Xinyuan-LilyGO/T-CameraPlus-S3/relevant_test/PowerConsumptionTestLog_[T-CameraPlus-S3_V1.2]_20250408.pdf

# T-CameraPlus-S3_V1.2 Power Consumption Test Log

## 1. Test Environment Description

Test Tools | Sampling speed | Test Methodology | Input voltage | Test environment temperature
BLU939 | 100000 times/s | Battery Interface Measurement | +4.0V | 25°C/77°F

www.lilygo.cc

Date: 20250408
LastEditTime: 20250408
Test board: T-CameraPlus-S3_V1.2（202503071622） Software name: Deep_Sleep_Wake_Up.ino
Testing organization: LILYGO Laboratory

## 2. Test Physical Object Image

Test device | MCU | Power amplifier | Microphone | Camera
Corresponding
model | ESP32S3 | MAX98357AETE+T | MP34DT05TR-A | OV2640

1.1 测试环境
1.1 Test environment

1.2 测试的器件型号
1.2 Test device model

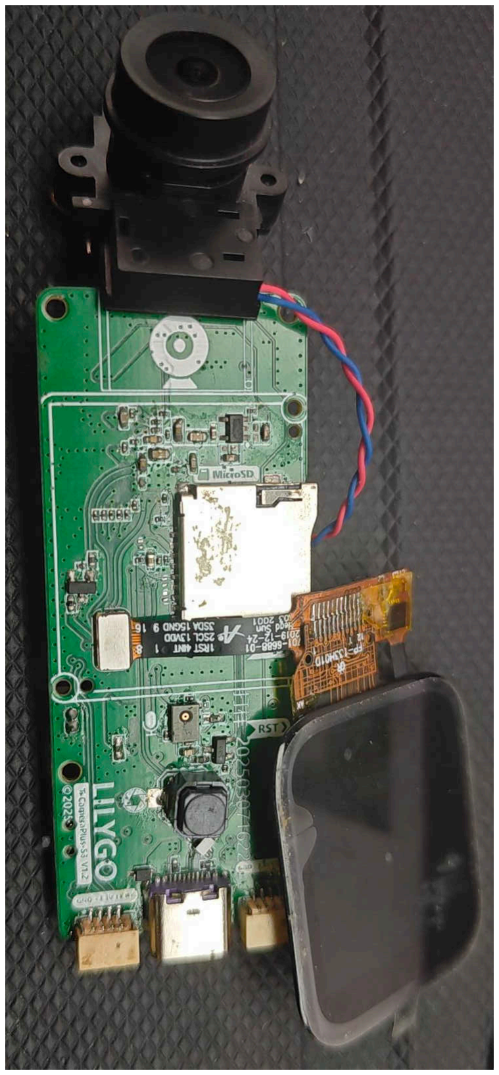
[picture p8: figure]
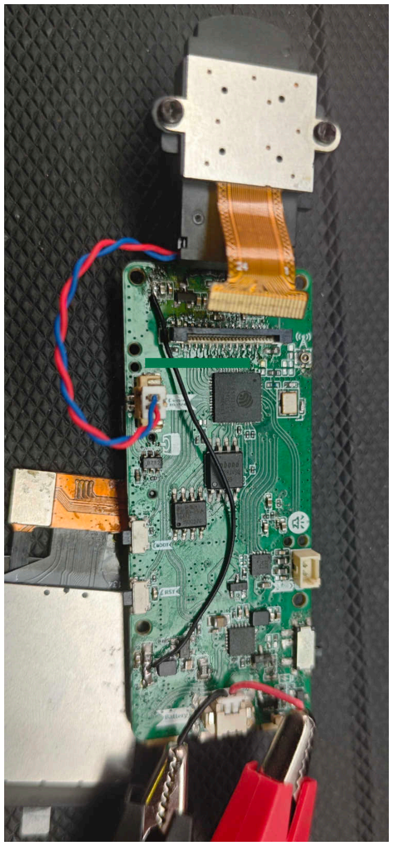
[picture p9: figure]
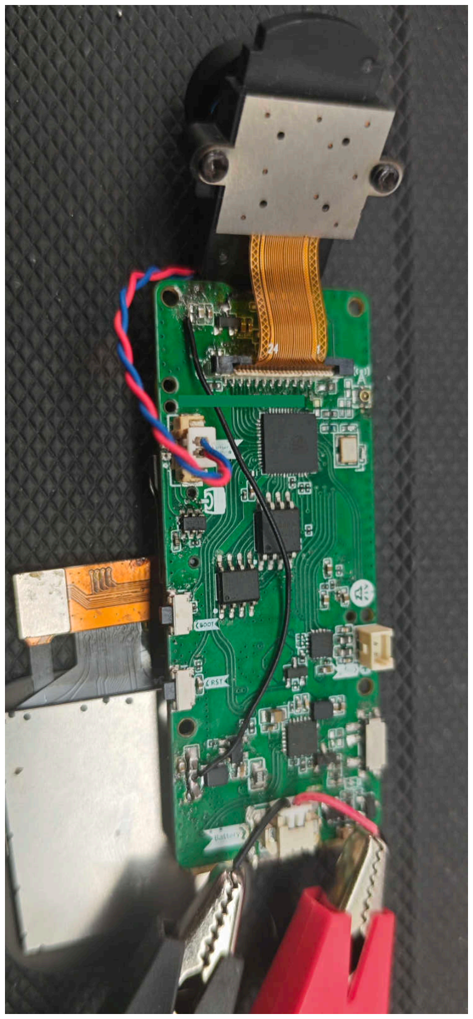
[picture p10: figure]

## 4. Power consumption testing

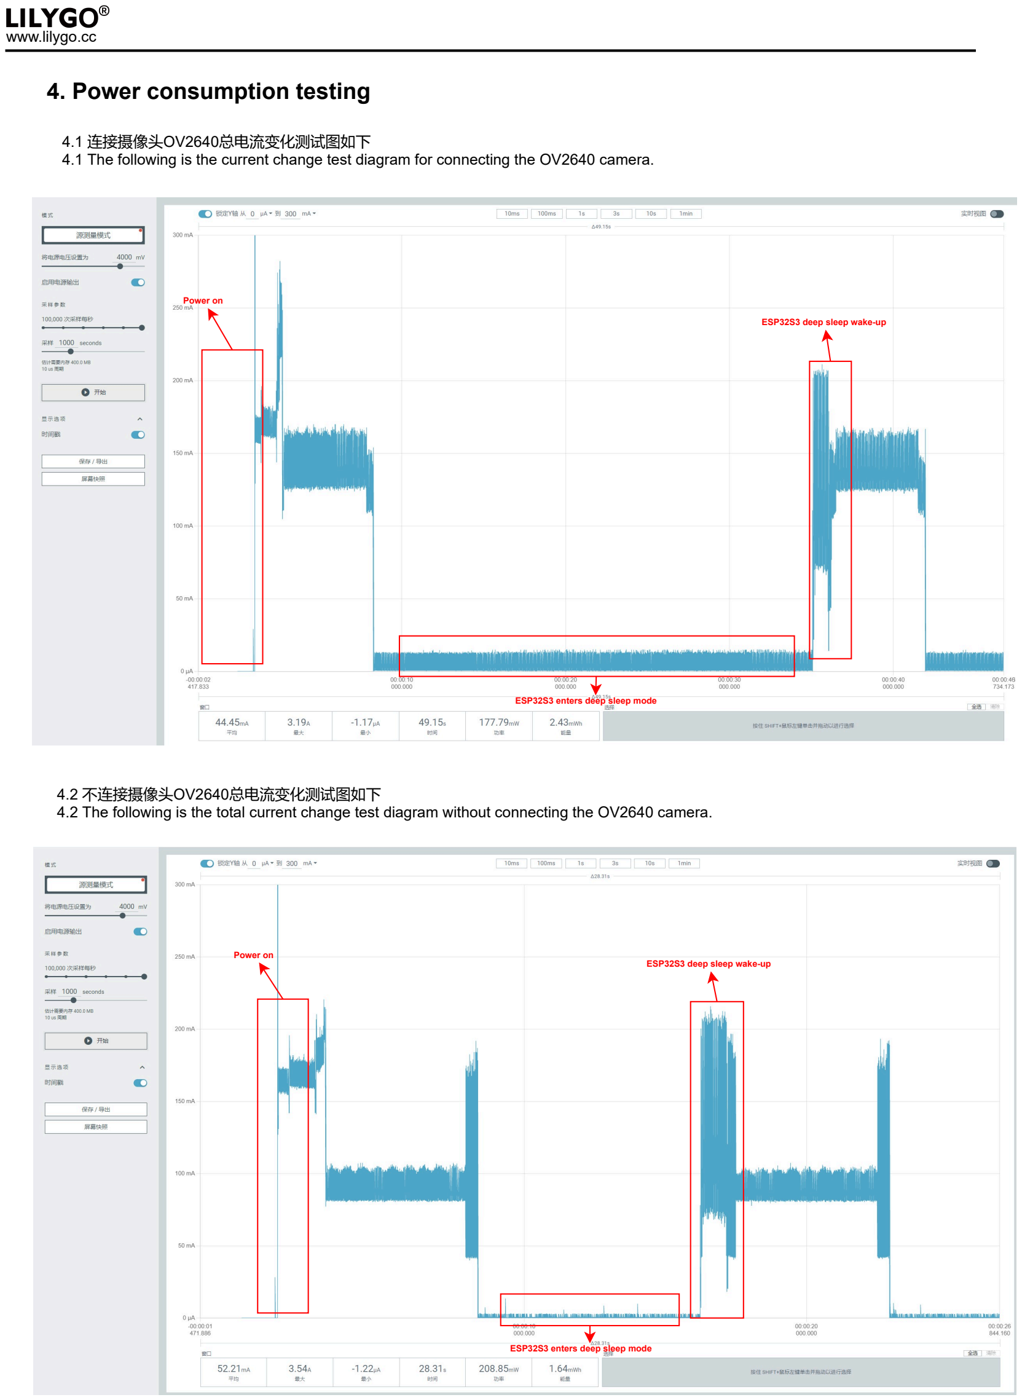
[picture p11: page 2]

Power on

4.1 连接摄像头OV2640总电流变化测试图如下
4.1 The following is the current change test diagram for connecting the OV2640 camera.

ESP32S3 deep sleep wake-up

4.2 不连接摄像头OV2640总电流变化测试图如下
4.2 The following is the total current change test diagram without connecting the OV2640 camera.

ESP32S3 enters deep sleep mode

Power on
ESP32S3 deep sleep wake-up

ESP32S3 enters deep sleep mode

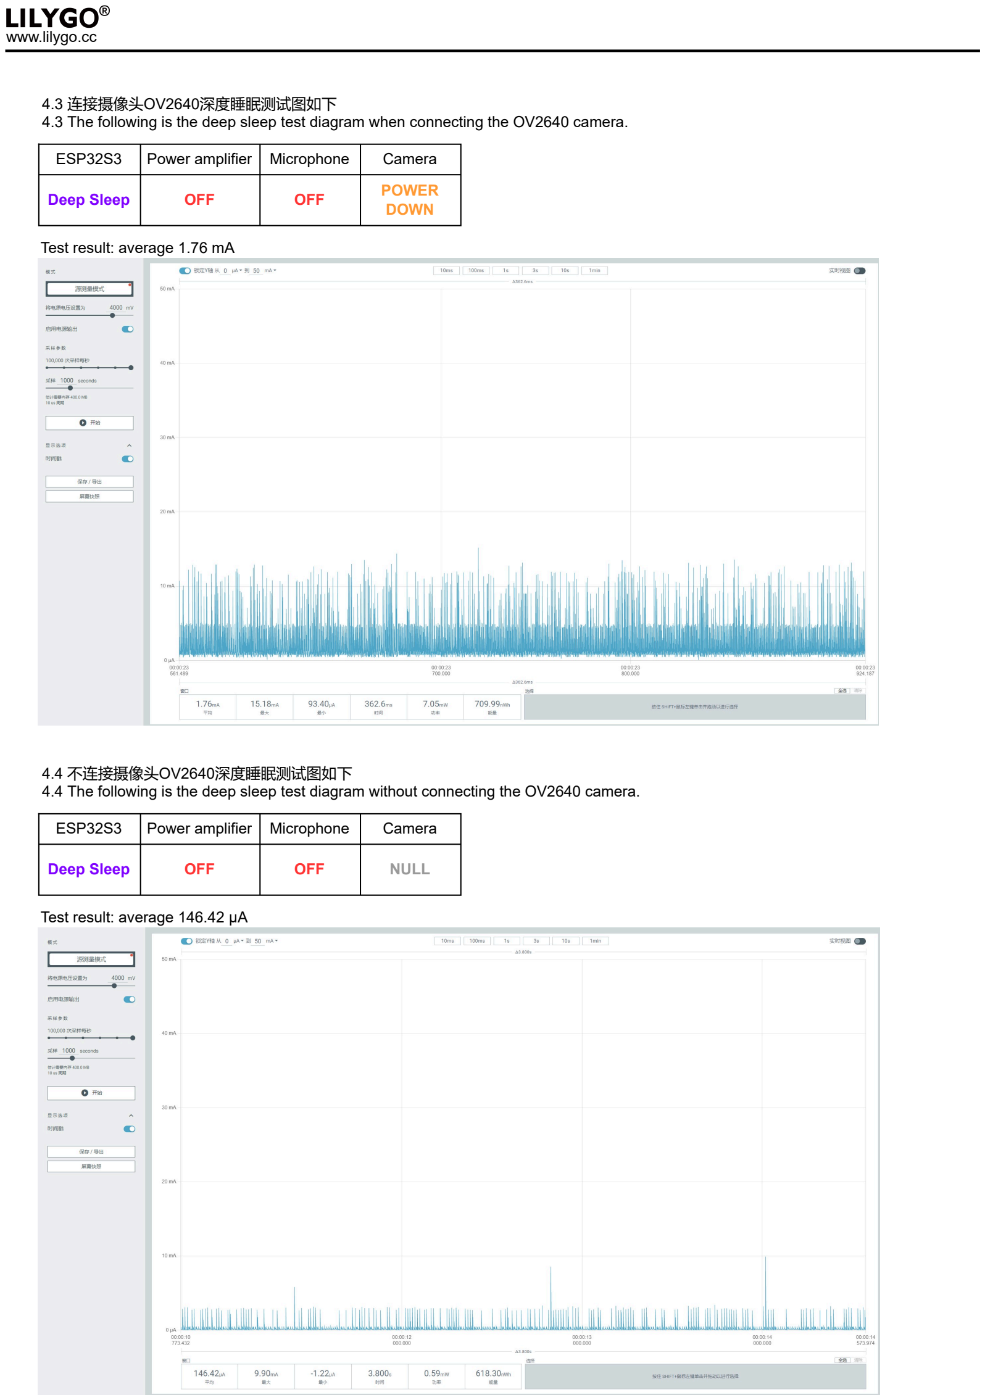
[picture p12: page 3]

4.3 连接摄像头OV2640深度睡眠测试图如下
4.3 The following is the deep sleep test diagram when connecting the OV2640 camera.
ESP32S3 | Power amplifier | Microphone | Camera
Deep Sleep | OFF | OFF | POWER DOWN

Test result: average 1.76 mA

4.4 不连接摄像头OV2640深度睡眠测试图如下
4.4 The following is the deep sleep test diagram without connecting the OV2640 camera.
ESP32S3 | Power amplifier | Microphone | Camera
Deep Sleep | OFF | OFF | NULL

Test result: average 146.42 μA
