Xinyuan-LilyGO/T-CameraPlus-S3/project/T-CameraPlus-S3_V1.2_20240417.pdf

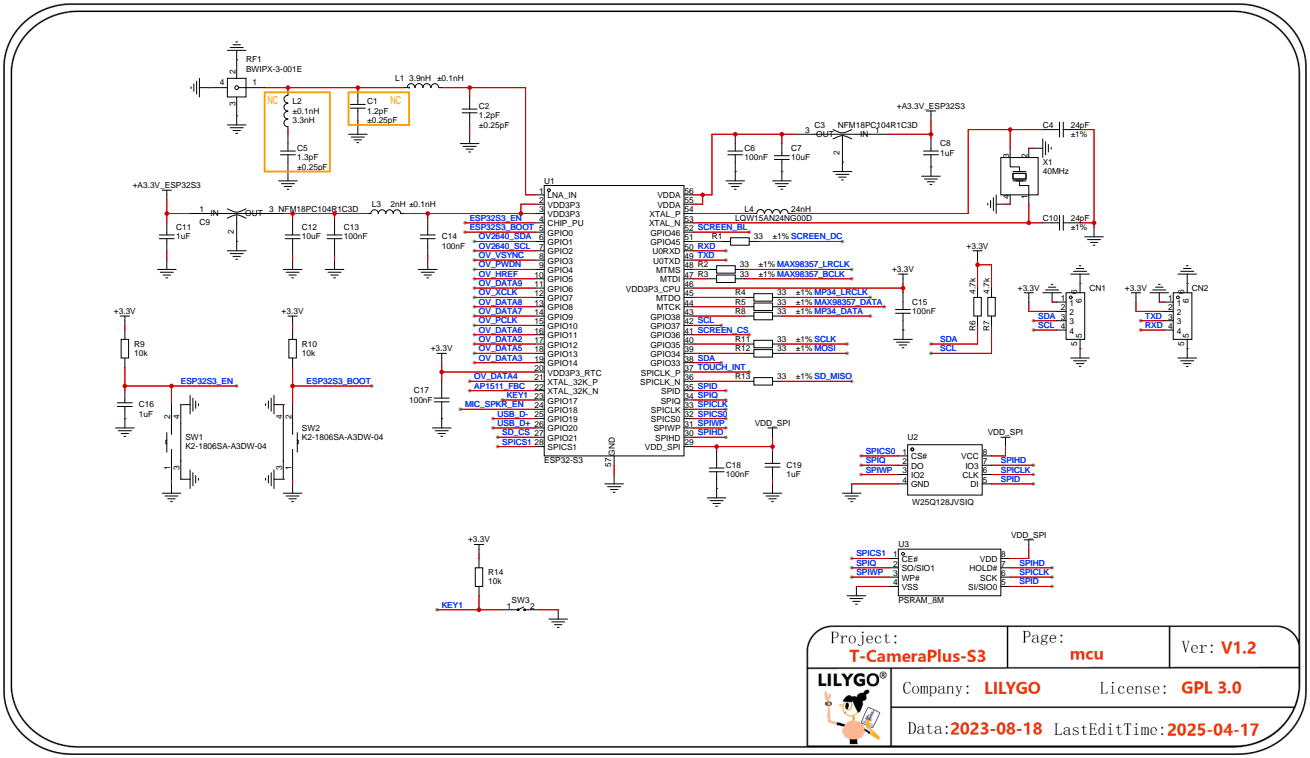
[picture p13: page 1]

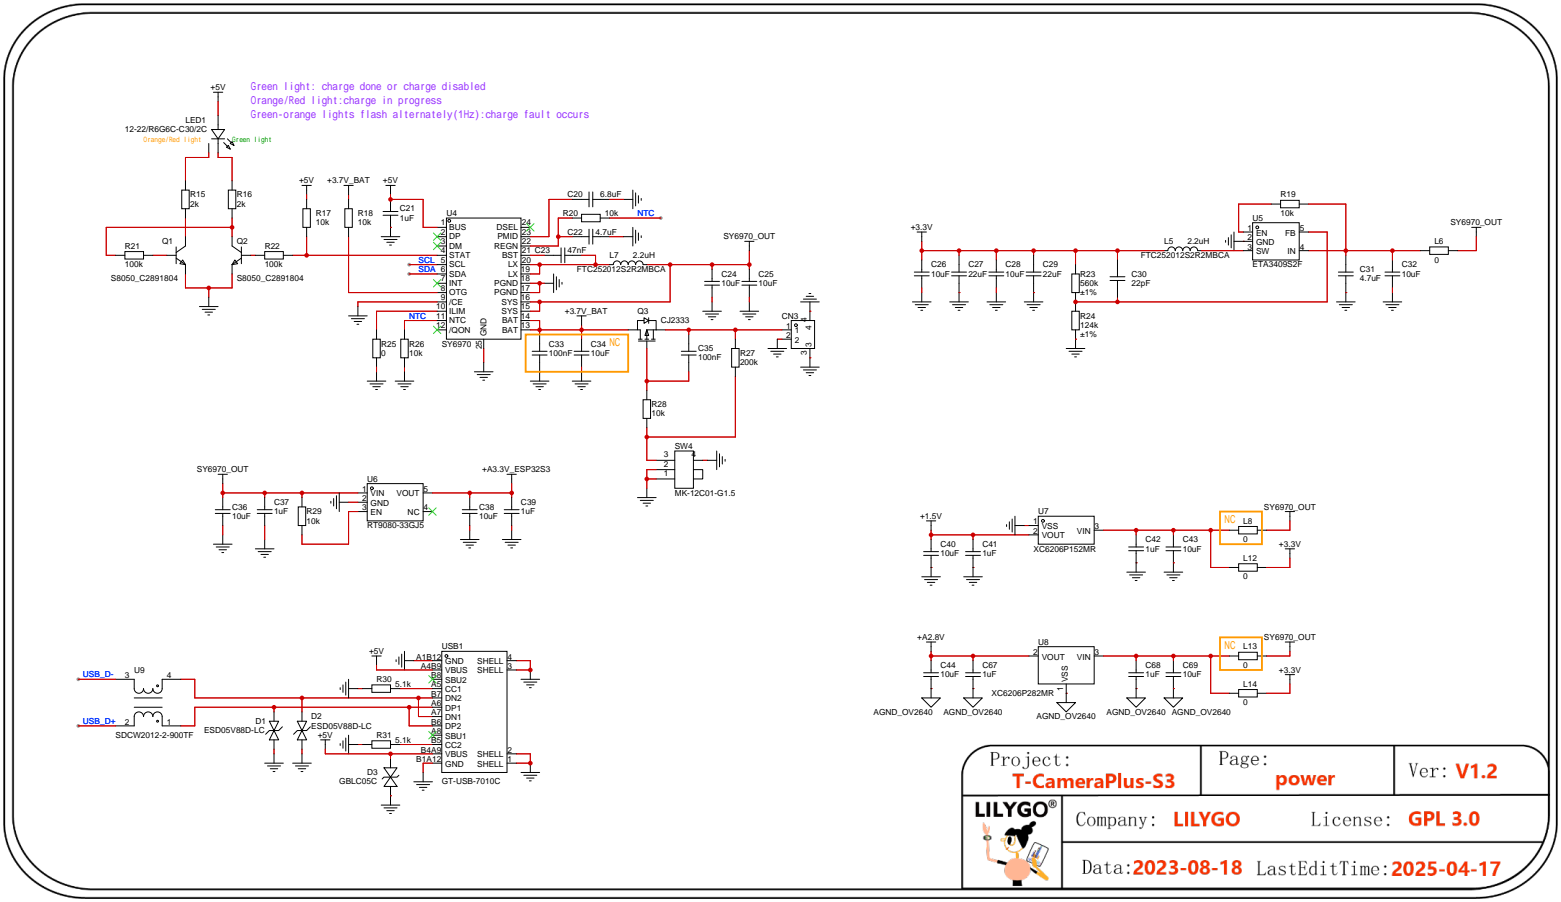
[picture p14: page 2]

Orange/Red light:charge in progress
Green-orange lights flash alternately(1Hz):charge fault occurs

### 1Pin 24Pin

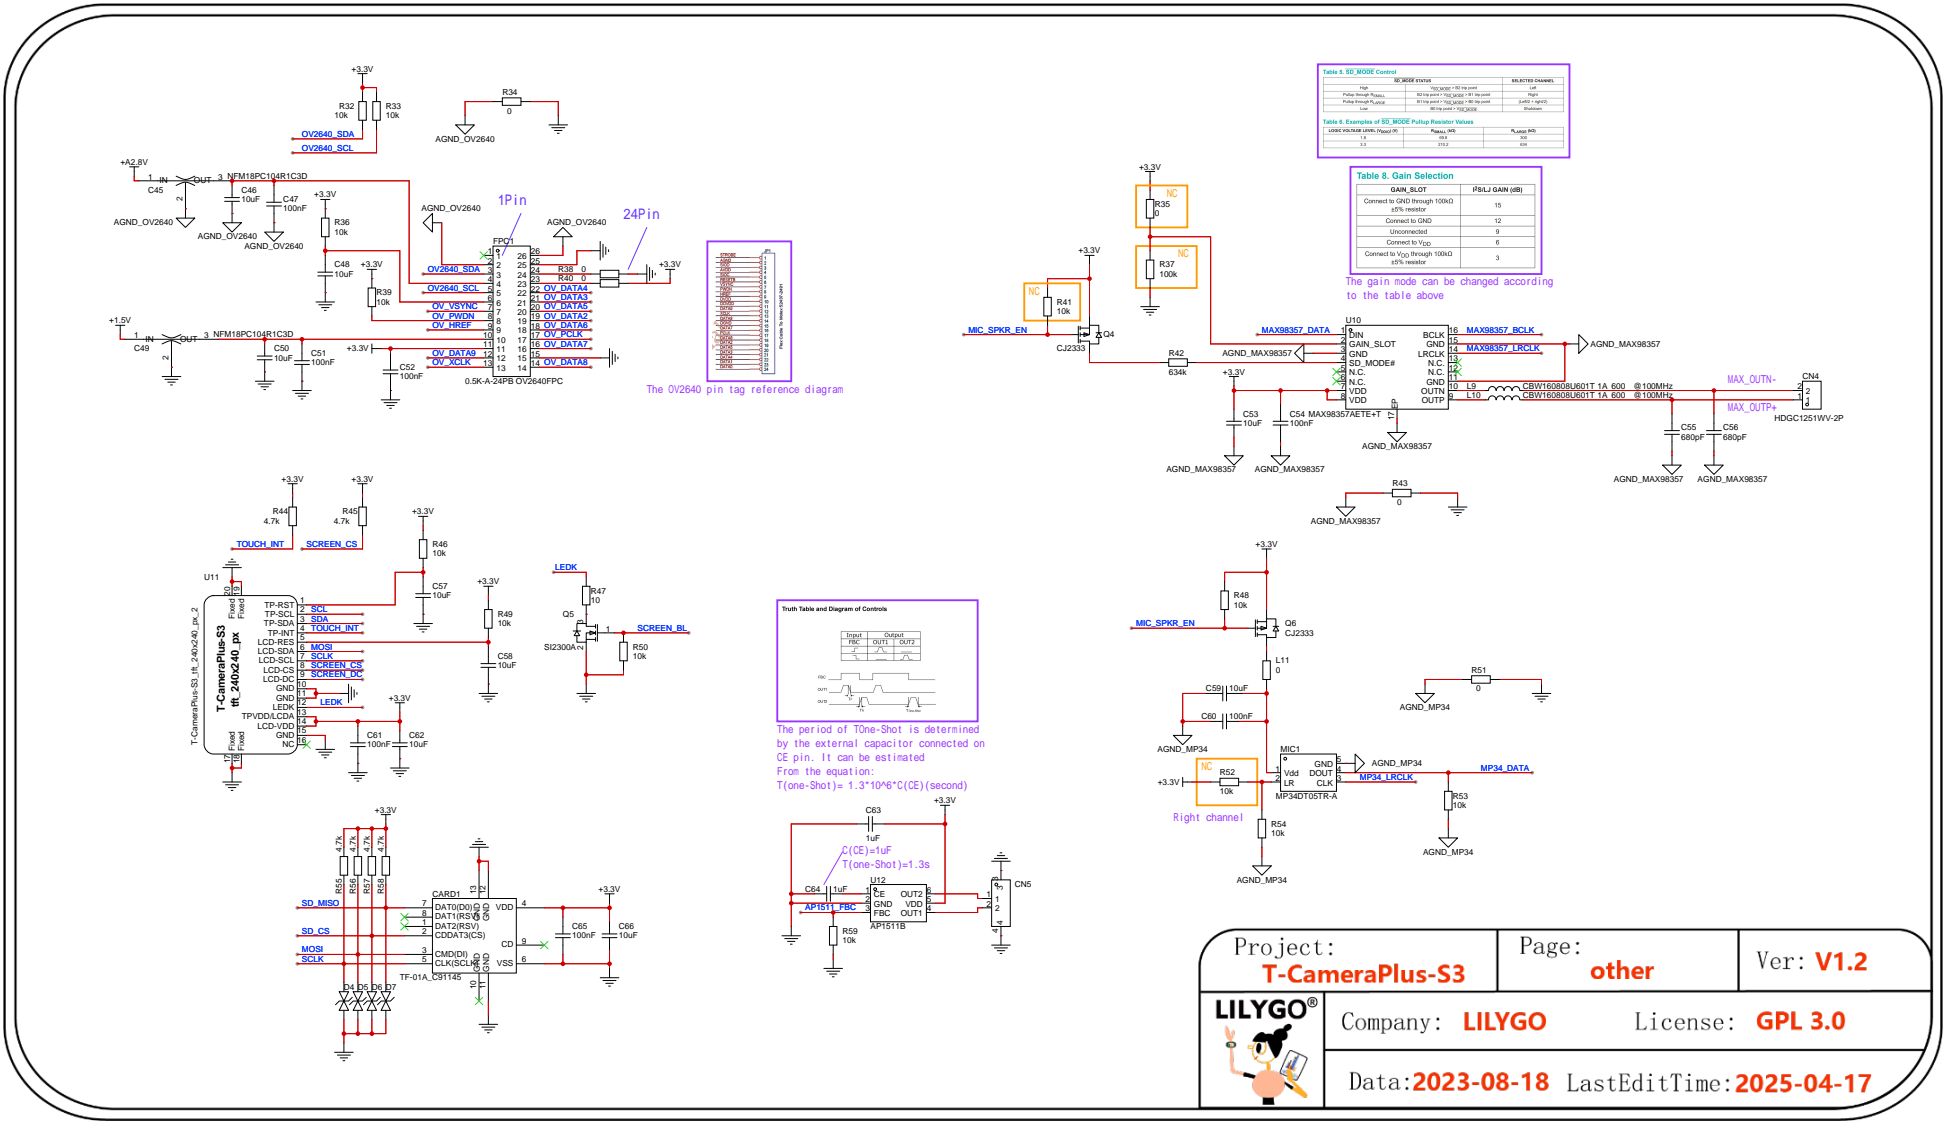
[picture p15: page 3]

The gain mode can be changed according
to the table above

The OV2640 pin tag reference diagram

Fixed 18 Fixed 17 Fixed 20 Fixed 19

The period of TOne-Shot is determined
by the external capacitor connected on
CE pin. It can be estimated
From the equation:
T(one-Shot)= 1.3*10^6*C(CE)(second)
