Xinyuan-LilyGO/T-CameraPlus-S3/project/SCH_T-CameraPlus-S3_V1.1_20240606.pdf

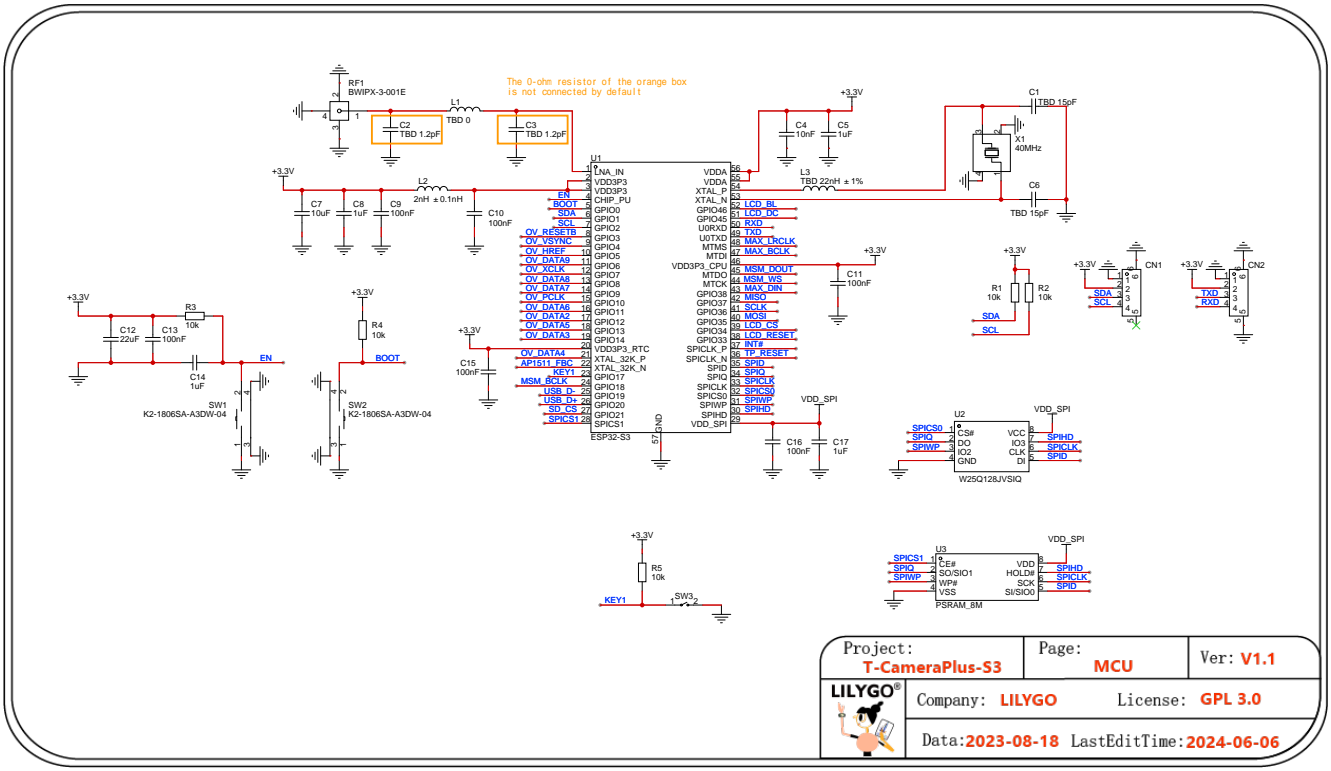
[picture p19: page 1]

is not connected by default

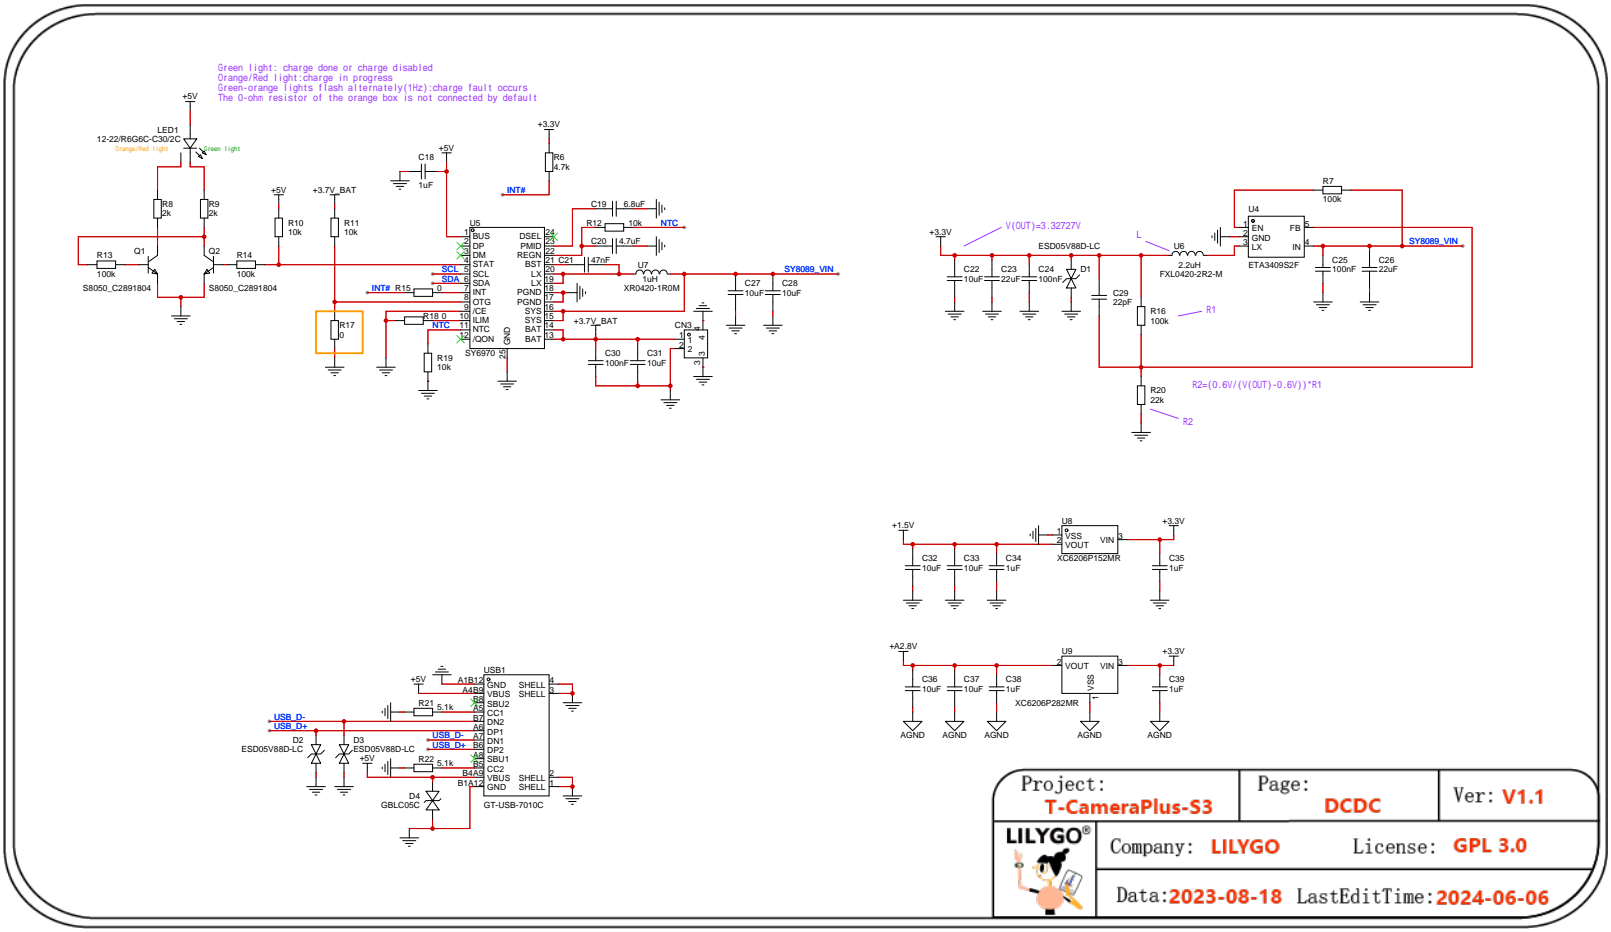
[picture p20: page 2]

Green light: charge done or charge disabled
Orange/Red light:charge in progress
Green-orange lights flash alternately(1Hz):charge fault occurs
The 0-ohm resistor of the orange box is not connected by default

13 13 14 14 15 15 16 16 17 17 18 18 19 19 20 20 21 21 22 22 23 23 24 24 25 25 26 26

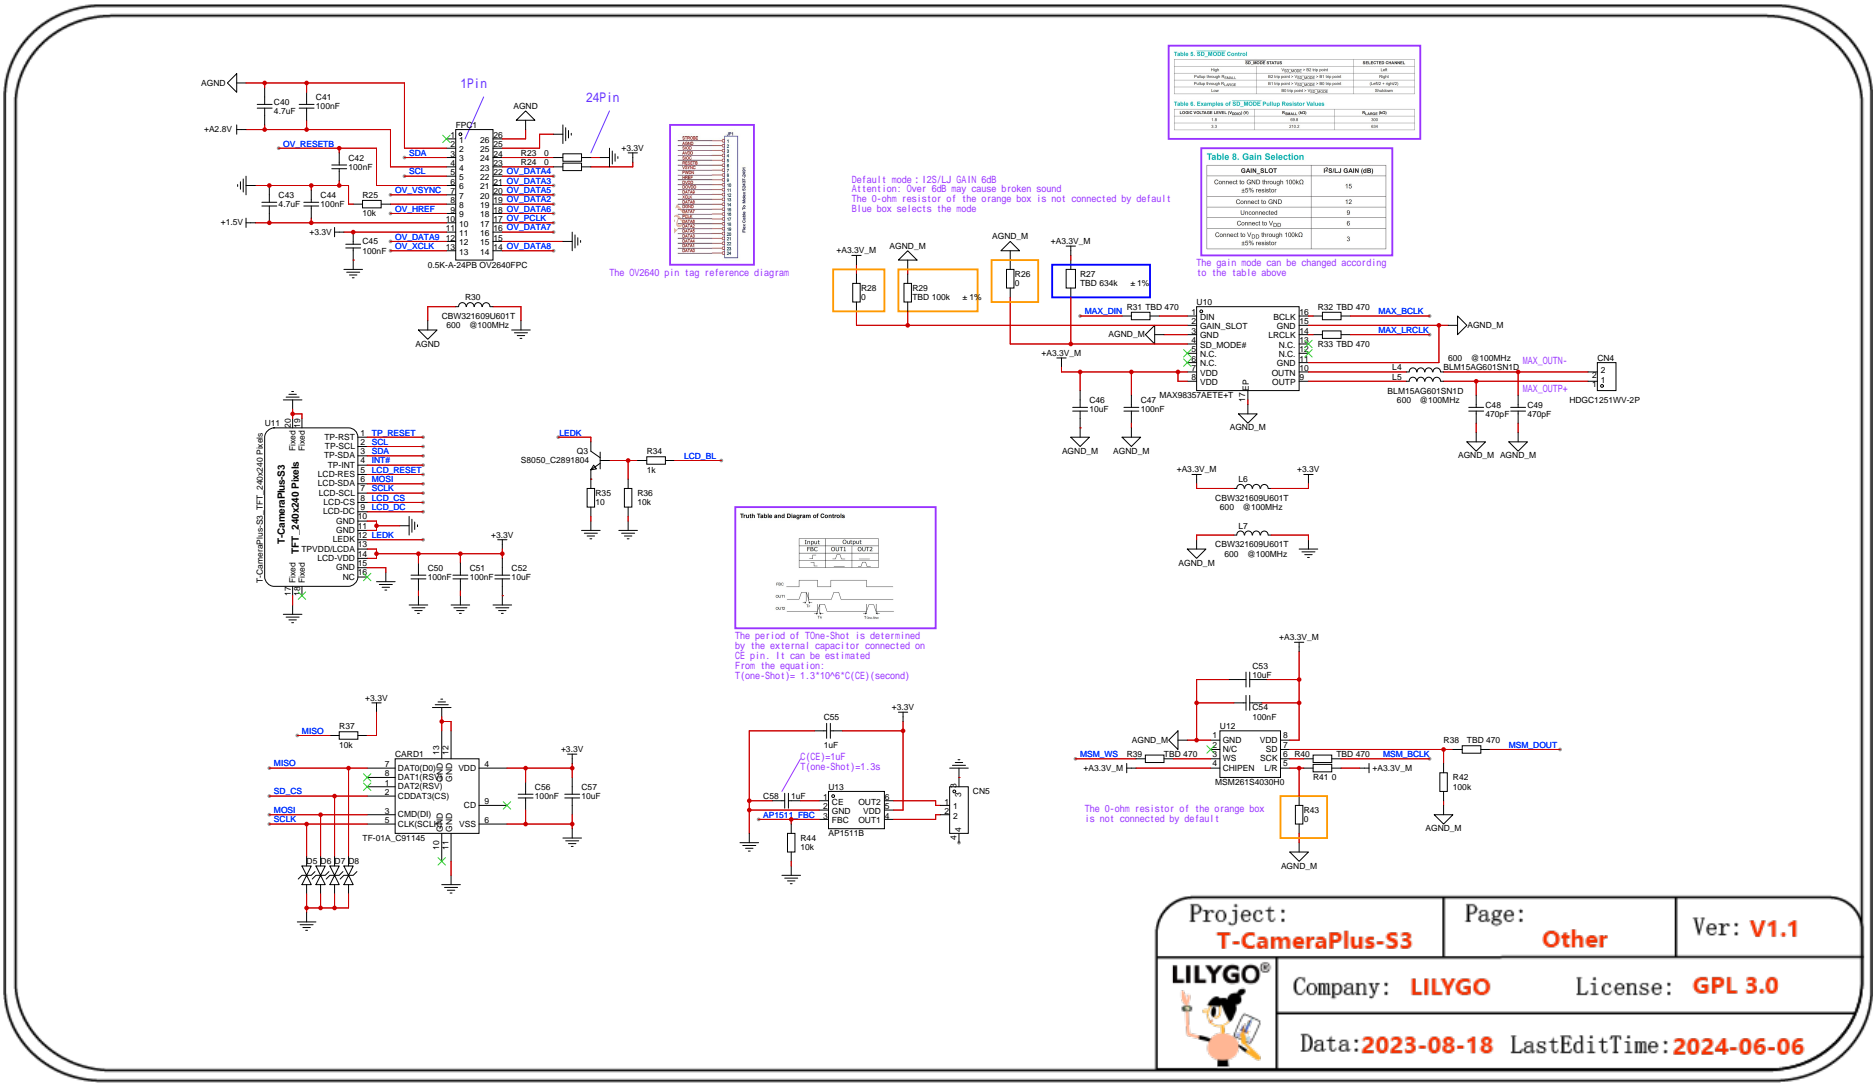
[picture p21: page 3]

Default mode：I2S/LJ GAIN 6dB
Attention: Over 6dB may cause broken sound
The 0-ohm resistor of the orange box is not connected by default
Blue box selects the mode

The gain mode can be changed according

The OV2640 pin tag reference diagram

Fixed 18 Fixed 17 Fixed 20 Fixed

The period of TOne-Shot is determined
by the external capacitor connected on
CE pin. It can be estimated
From the equation:
T(one-Shot)= 1.3*10^6*C(CE)(second)

The 0-ohm resistor of the orange box
is not connected by default
