Xinyuan-LilyGO/T-CameraPlus-S3/examples/SD_MJPEG_Mp3/SD_MJPEG_Mp3.ino

/*
 * @Description(CN):
 *      使用SD卡播放MJPEG格式文件 同时播放MP3文件
 *
 * @Description(EN):
 *       Translate to English: Play MJPEG format file using SD card while playing MP3 file
 *  simultaneously.
 *
 * @version: V1.0.0
 * @Author: LILYGO_L
 * @Date: 2023-09-22 17:37:56
 * @LastEditors: LILYGO_L
 * @LastEditTime: 2023-11-22 15:32:25
 * @License: GPL 3.0
 */

#include <WiFi.h>
#include <FS.h>
#include <SD.h>
#include "Arduino_GFX_Library.h"
#include "Audio.h"
#include "pin_config.h"

#define AUDIO_FILENAME "/44100Hz_32k.mp3"

// #define MJPEG_FILENAME "/240x240px_60fps.mjpeg"
#define MJPEG_FILENAME "/240x240px_30fps.mjpeg"
#define FPS 30
#define MJPEG_BUFFER_SIZE (240 * 240 * 2 / 10)

#define CHART_MARGIN 64
#define LEGEND_A_COLOR 0x1BB6
#define LEGEND_B_COLOR 0xFBE1
#define LEGEND_C_COLOR 0x2D05
#define LEGEND_D_COLOR 0xD125
#define LEGEND_E_COLOR 0x9337
#define LEGEND_F_COLOR 0x8AA9
#define LEGEND_G_COLOR 0xE3B8
#define LEGEND_H_COLOR 0x7BEF
#define LEGEND_I_COLOR 0xBDE4
#define LEGEND_J_COLOR 0x15F9

/* variables */
static int next_frame = 0;
static int skipped_frames = 0;
static unsigned long start_ms, curr_ms, next_frame_ms;
static unsigned long total_read_video_ms = 0;
static unsigned long total_decode_video_ms = 0;
static unsigned long total_show_video_ms = 0;
static int time_used = 0;
static int total_frames = 0;

// fp-133h01d
Arduino_DataBus *bus = new Arduino_HWSPI(
    LCD_DC /* DC */, LCD_CS /* CS */, LCD_SCLK /* SCK */, LCD_MOSI /* MOSI */, -1 /* MISO */);

Arduino_GFX *gfx = new Arduino_ST7789(
    bus, LCD_RST /* RST */, 0 /* rotation */, true /* IPS */,
    LCD_WIDTH /* width */, LCD_HEIGHT /* height */,
    0 /* col offset 1 */, 0 /* row offset 1 */, 0 /* col_offset2 */, 0 /* row_offset2 */);

Audio audio;

/* MJPEG Video */
#include "MjpegClass.h"
static MjpegClass mjpeg;

void Task1(void *pvParameters)
{
    while (1)
    {
        audio.loop();
    }
}

// pixel drawing callback
static int drawMCU(JPEGDRAW *pDraw)
{
    // Serial.printf("Draw pos = (%d, %d), size = %d x %d\n", pDraw->x, pDraw->y, pDraw->iWidth, pDraw->iHeight);
    unsigned long s = millis();
    gfx->draw16bitBeRGBBitmap(pDraw->x, pDraw->y, pDraw->pPixels, pDraw->iWidth, pDraw->iHeight);
    total_show_video_ms += millis() - s;
    return 1;
} /* drawMCU() */

void Mjpeg_Data_Statistics(void)
{
    int played_frames = total_frames - skipped_frames;
    float fps = 1000.0 * played_frames / time_used;
    total_decode_video_ms -= total_show_video_ms;
    Serial.printf("Played frames: %d\n", played_frames);
    Serial.printf("Skipped frames: %d (%0.1f %%)\n", skipped_frames, 100.0 * skipped_frames / total_frames);
    Serial.printf("Time used: %d ms\n", time_used);
    Serial.printf("Expected FPS: %d\n", FPS);
    Serial.printf("Actual FPS: %0.1f\n", fps);
    Serial.printf("Read video: %lu ms (%0.1f %%)\n", total_read_video_ms, 100.0 * total_read_video_ms / time_used);
    Serial.printf("Decode video: %lu ms (%0.1f %%)\n", total_decode_video_ms, 100.0 * total_decode_video_ms / time_used);
    Serial.printf("Show video: %lu ms (%0.1f %%)\n", total_show_video_ms, 100.0 * total_show_video_ms / time_used);

    // gfx->setCursor(0, 0);
    gfx->setTextColor(WHITE);
    gfx->printf("Played frames: %d\n", played_frames);
    gfx->printf("Skipped frames: %d (%0.1f %%)\n", skipped_frames, 100.0 * skipped_frames / total_frames);
    gfx->printf("Time used: %d ms\n", time_used);
    gfx->printf("Expected FPS: %d\n", FPS);
    gfx->printf("Actual FPS: %0.1f\n\n", fps);

    int16_t r1 = ((gfx->height() - CHART_MARGIN - CHART_MARGIN) / 2);
    int16_t r2 = r1 / 2;
    int16_t cx = gfx->width() - r1 - 10;
    int16_t cy = r1 + CHART_MARGIN;

    float arc_start3 = 0;
    float arc_end3 = arc_start3 + max(2.0, 360.0 * total_read_video_ms / time_used);
    for (int i = arc_start3 + 1; i < arc_end3; i += 2)
    {
        gfx->fillArc(cx, cy, r1, r2, arc_start3 - 90.0, i - 90.0, LEGEND_C_COLOR);
    }
    gfx->fillArc(cx, cy, r1, r2, arc_start3 - 90.0, arc_end3 - 90.0, LEGEND_C_COLOR);
    gfx->setTextColor(LEGEND_C_COLOR);
    gfx->printf("Read video: %lu ms (%0.1f %%)\n", total_read_video_ms, 100.0 * total_read_video_ms / time_used);

    float arc_start4 = arc_end3;
    float arc_end4 = arc_start4 + max(2.0, 360.0 * total_decode_video_ms / time_used);
    for (int i = arc_start4 + 1; i < arc_end4; i += 2)
    {
        gfx->fillArc(cx, cy, r1, r2, arc_start4 - 90.0, i - 90.0, LEGEND_D_COLOR);
    }
    gfx->fillArc(cx, cy, r1, r2, arc_start4 - 90.0, arc_end4 - 90.0, LEGEND_D_COLOR);
    gfx->setTextColor(LEGEND_D_COLOR);
    gfx->printf("Decode video: %lu ms (%0.1f %%)\n", total_decode_video_ms, 100.0 * total_decode_video_ms / time_used);

    float arc_start5 = arc_end4;
    float arc_end5 = arc_start5 + max(2.0, 360.0 * total_show_video_ms / time_used);
    for (int i = arc_start5 + 1; i < arc_end5; i += 2)
    {
        gfx->fillArc(cx, cy, r2, 0, arc_start5 - 90.0, i - 90.0, LEGEND_E_COLOR);
    }
    gfx->fillArc(cx, cy, r2, 0, arc_start5 - 90.0, arc_end5 - 90.0, LEGEND_E_COLOR);
    gfx->setTextColor(LEGEND_E_COLOR);
    gfx->printf("Show video: %lu ms (%0.1f %%)\n", total_show_video_ms, 100.0 * total_show_video_ms / time_used);
}

void setup()
{
    // Disable low voltage detection to avoid infinite reboot.
    WRITE_PERI_REG(RTC_CNTL_BROWN_OUT_REG, 0);

    WiFi.mode(WIFI_OFF);
    Serial.begin(115200);

    pinMode(LCD_BL, OUTPUT);
    ledcAttachPin(LCD_BL, 1); // assign TFT_BL pin to channel 1
    ledcSetup(1, 20000, 8);   // 12 kHz PWM, 8-bit resolution
    ledcWrite(1, 255);        // brightness 0 - 255

    SPI.begin(SCLK, MISO, MOSI, SD_CS); // SPI boots

    while (!gfx->begin(80000000))
    {
        Serial.println("Init display failed!");
        delay(1000);
    }
    gfx->fillScreen(BLACK);
    Serial.println("Init display successful");
    gfx->println("Init display successful");

    while (!SD.begin(SD_CS, SPI, 80000000)) /* SPI bus mode */
    {
        Serial.println("ERROR: SD card mount failed!");
        gfx->println("ERROR: SD card mount failed!");
        delay(1000);
    }

    Serial.println("Init SD successful");
    gfx->println("Init SD successful");

    audio.setPinout(MAX98357A_BCLK, MAX98357A_LRCLK, MAX98357A_DOUT);
    audio.setVolume(11);   // 0...21,Volume setting
    audio.forceMono(true); // change stereo to mono

    gfx->println("Open video file: " MJPEG_FILENAME);
    File vFile = SD.open(MJPEG_FILENAME);
    while (!vFile || vFile.isDirectory())
    {
        Serial.println("ERROR: Failed to open " MJPEG_FILENAME " file for reading");
        gfx->println("ERROR: Failed to open " MJPEG_FILENAME " file for reading");

        delay(1000);
    }

    gfx->println("Open audio file: " AUDIO_FILENAME);
    File aFile = SD.open(AUDIO_FILENAME);
    while (!aFile || aFile.isDirectory())
    {
        Serial.println("ERROR: Failed to open " AUDIO_FILENAME " file for reading");
        gfx->println("ERROR: Failed to open " AUDIO_FILENAME " file for reading");

        delay(1000);
    }

    uint8_t *mjpeg_buf = (uint8_t *)malloc(MJPEG_BUFFER_SIZE);
    if (!mjpeg_buf)
    {
        Serial.println("mjpeg_buf malloc failed!");
        gfx->println("mjpeg_buf malloc failed!");
    }
    else
    {
        gfx->println("Init video");
        mjpeg.setup(
            &vFile, mjpeg_buf, drawMCU, true /* useBigEndian */,
            0 /* x */, 0 /* y */, gfx->width() /* widthLimit */, gfx->height() /* heightLimit */);

        gfx->println("Start play video:" MJPEG_FILENAME);
        start_ms = millis();
        curr_ms = millis();
        next_frame_ms = start_ms + (++next_frame * 1000 / FPS / 2);
        gfx->println("Start play audio:" AUDIO_FILENAME);
        audio.connecttoFS(SD, AUDIO_FILENAME);
        xTaskCreatePinnedToCore(Task1, "Task1", 2000, NULL, configMAX_PRIORITIES - 1, NULL, 1);
        while (vFile.available() && mjpeg.readMjpegBuf()) // Read video
        {
            total_read_video_ms += millis() - curr_ms;
            curr_ms = millis();

            if (millis() < next_frame_ms) // check show frame or skip frame
            {
                // Play video
                mjpeg.drawJpg();
                total_decode_video_ms += millis() - curr_ms;
                curr_ms = millis();
            }
            else
            {
                ++skipped_frames;
                // Serial.println("Skip frame");
            }

            while (millis() < next_frame_ms)
            {
                vTaskDelay(pdMS_TO_TICKS(1));
            }

            curr_ms = millis();
            next_frame_ms = start_ms + (++next_frame * 1000 / FPS);
        }
        time_used = millis() - start_ms;
        total_frames = next_frame - 1;
        Serial.println("MJPEG video end");
        vFile.close();

        delay(200);

        Mjpeg_Data_Statistics();
    }
}

void loop()
{
}
