Xinyuan-LilyGO/T-CameraPlus-S3/examples/Camera_WebServer_OV5640_Auto_Focus/Camera_WebServer_OV5640_Auto_Focus.ino

/*
 * @Description(CN):
 *      OV2640连接Wifi投影
 *
 * @Description(EN):
 *      OV2640 connected to WiFi projection
 *
 * @version: V1.0.0
 * @Author: LILYGO_L
 * @Date: 2023-08-25 15:53:44
 * @LastEditors: Please set LastEditors
 * @LastEditTime: 2024-11-19 18:10:53
 * @License: GPL 3.0
 */
#include <WiFi.h>
#include "camera_index.h"
#include "app_httpd.tpp"
#include "pin_config.h"
#include "ESP32_OV5640_AF.h"

// #define WIFI_SSID "xinyuandianzi"
// #define WIFI_PASSWORD "AA15994823428"
#define WIFI_SSID "LilyGo-AABB"
#define WIFI_PASSWORD "xinyuandianzi"

OV5640 ov5640 = OV5640();

bool Camera_Initialization(void)
{
    camera_config_t config;
    config.ledc_channel = LEDC_CHANNEL_0;
    config.ledc_timer = LEDC_TIMER_0;
    config.pin_d0 = Y2_GPIO_NUM;
    config.pin_d1 = Y3_GPIO_NUM;
    config.pin_d2 = Y4_GPIO_NUM;
    config.pin_d3 = Y5_GPIO_NUM;
    config.pin_d4 = Y6_GPIO_NUM;
    config.pin_d5 = Y7_GPIO_NUM;
    config.pin_d6 = Y8_GPIO_NUM;
    config.pin_d7 = Y9_GPIO_NUM;
    config.pin_xclk = XCLK_GPIO_NUM;
    config.pin_pclk = PCLK_GPIO_NUM;
    config.pin_vsync = VSYNC_GPIO_NUM;
    config.pin_href = HREF_GPIO_NUM;
    config.pin_sccb_sda = SIOD_GPIO_NUM;
    config.pin_sccb_scl = SIOC_GPIO_NUM;
    config.pin_pwdn = PWDN_GPIO_NUM;
    config.pin_reset = RESET_GPIO_NUM;
    config.xclk_freq_hz = 20000000;
    config.frame_size = FRAMESIZE_VGA;
    config.pixel_format = PIXFORMAT_JPEG; // for streaming
    // config.pixel_format = PIXFORMAT_RGB565; // for face detection/recognition
    config.grab_mode = CAMERA_GRAB_WHEN_EMPTY;
    config.fb_location = CAMERA_FB_IN_PSRAM;
    config.jpeg_quality = 20;
    config.fb_count = 2;

    // camera init
    esp_err_t err = esp_camera_init(&config);
    if (err != ESP_OK)
    {
        Serial.printf("Camera init failed with error 0x%x", err);

        return false;
    }

    sensor_t *s = esp_camera_sensor_get();
    if (s)
    {
        Serial.print("camera id:");
        Serial.println(s->id.PID);
        camera_sensor_info_t *sinfo = esp_camera_sensor_get_info(&(s->id));
        if (sinfo)
        {
            Serial.print("camera model:");
            Serial.println(sinfo->name);
        }
    }
    // initial sensors are flipped vertically and colors are a bit saturated
    if (s->id.PID == OV3660_PID)
    {
        s->set_vflip(s, 1);       // flip it back
        s->set_brightness(s, 1);  // up the brightness just a bit
        s->set_saturation(s, -2); // lower the saturation
    }

    if (s->id.PID == OV5640_PID)
    {
        s->set_vflip(s, 1);   // 上下翻转
        s->set_hmirror(s, 0); // 镜像翻转
    }

    return true;
}

void setup()
{
    Serial.begin(115200);
    Serial.setDebugOutput(true);
    Serial.println();

    if (Camera_Initialization() == true)
    {
        sensor_t *sensor = esp_camera_sensor_get();
        ov5640.start(sensor);

        if (ov5640.focusInit() == 0)
        {
            Serial.println("OV5640_Focus_Init Successful!");
        }
        else
        {
            Serial.println("OV5640_Focus_Init Failed!");
        }

        if (ov5640.autoFocusMode() == 0)
        {
            Serial.println("OV5640_Auto_Focus Successful!");
        }
        else
        {
            Serial.println("OV5640_Auto_Focus Failed!");
        }
    }

    WiFi.begin(WIFI_SSID, WIFI_PASSWORD);
    WiFi.setSleep(false);

    while (WiFi.status() != WL_CONNECTED)
    {
        delay(500);
        Serial.print(".");
    }
    Serial.println("");
    Serial.println("WiFi connected");

    startCameraServer();

    Serial.print("Camera Ready! Use 'http://");
    Serial.print(WiFi.localIP());
    Serial.println("' to connect");
}

void loop()
{
    uint8_t rc = ov5640.getFWStatus();
    Serial.printf("FW_STATUS = 0x%x\n", rc);

    if (rc == -1)
    {
        Serial.println("Check your OV5640");
    }
    else if (rc == FW_STATUS_S_FOCUSED)
    {
        Serial.println("Focused!");
    }
    else if (rc == FW_STATUS_S_FOCUSING)
    {
        Serial.println("Focusing!");
    }
    else
    {
    }

    // camera_fb_t *fb = esp_camera_fb_get();

    // if (!fb)
    // {
    //     Serial.println("Camera capture failed");
    //     esp_camera_fb_return(fb);
    //     return;
    // }

    // if (fb->format != PIXFORMAT_JPEG)
    // {
    //     Serial.println("Non-JPEG data not implemented");
    //     esp_camera_fb_return(fb);
    //     return;
    // }

    // // Draw Image on the display or Send Image to the connected device!
    // // With (fb->buf, fb->len);
    // esp_camera_fb_return(fb);

    delay(100);
}
