Xinyuan-LilyGO/T-CameraPlus-S3/(commit log)

2023-12-20 Fix compatibility of lvgl with Arduino IDE
    [Lvgl_UI.ino, OV2640_Camera.cpp, OV2640_Camera.h, SD_MJPEG_Mp3.ino, SD_Music.ino, SY6970.cpp, SY6970.ino, TFT.ino]
2024-02-03 Fix OV2640 display bug
    [Lvgl_UI.ino, OV2640_Camera.cpp, custom.h, setup_scr_Camera.cpp]
2024-05-23 Update the latest schematic
2024-06-06 Delete project/SCH_T-CameraPlus-S3_V1.1.pdf
    Update schematic
2024-06-06 Update schematic
2024-08-21 Change the board model in Arduino IED #3
2024-08-29 Fix the board settings of Arduino IDE #3
2024-11-09 Modify the schematic of T-CameraPlus-S3_V1.1
2025-01-24 Update KEY1 power on/off example
2025-01-24 Update KEY1 power on/off example #7
2025-07-23 update to adapt to the esp-idf v5.4 framework
    [partitions.csv]
2025-08-25 update Arduino_DriveBus
2026-09-28 Add Dashcam example.
    [partitions.csv]
2026-10-19 fix: align SY6970 initialization with reference configuration
    - Set input current limit to 2000mA and keep ILIM enabled
    - Disable watchdog and set fast charge current to 512mA
    - Remove extra initialization settings to preserve chip defaults
    - Sync Lvgl_UI controls with actual chip settings
